selmanturunc/POSITION-CONTROL-OF-THE-BALL-ROLLING-ON-A-FLAT-PLATFORM/Design Drawings/servo_project 2.png

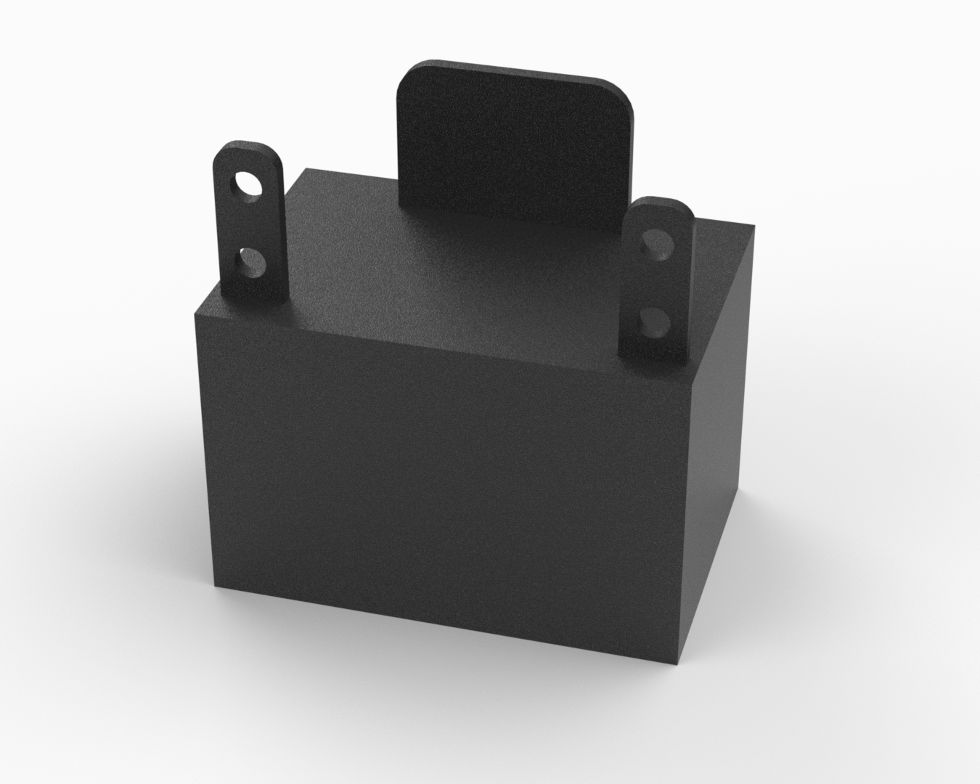
Design Drawings/servo_project 2.png
