selmanturunc/POSITION-CONTROL-OF-THE-BALL-ROLLING-ON-A-FLAT-PLATFORM/README.md

# 2 DoF Ball and Plate Project (PID and Fuzzy Logic Controller) 
### MARMARA UNIVERSITY,TURKEY
#### ME4098 - Engineering Project 
*Selman TURUNÇ*  <br/>
[LinkedIn](https://www.linkedin.com/in/selmanturunc/)
