selmanturunc/POSITION-CONTROL-OF-THE-BALL-ROLLING-ON-A-FLAT-PLATFORM/Design Drawings/BasePlane.png

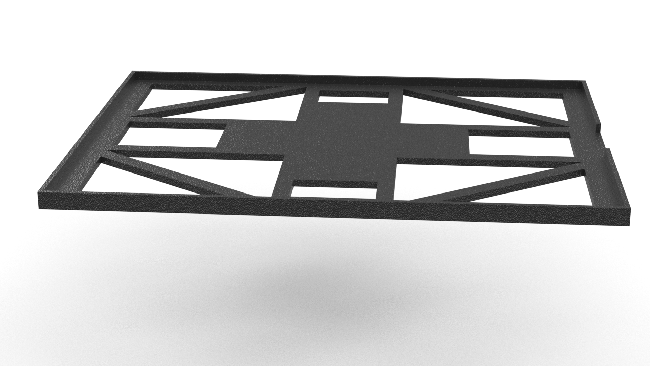
Design Drawings/BasePlane.png
