selmanturunc/POSITION-CONTROL-OF-THE-BALL-ROLLING-ON-A-FLAT-PLATFORM/Photos real system/IMG_20210701_142903.jpg

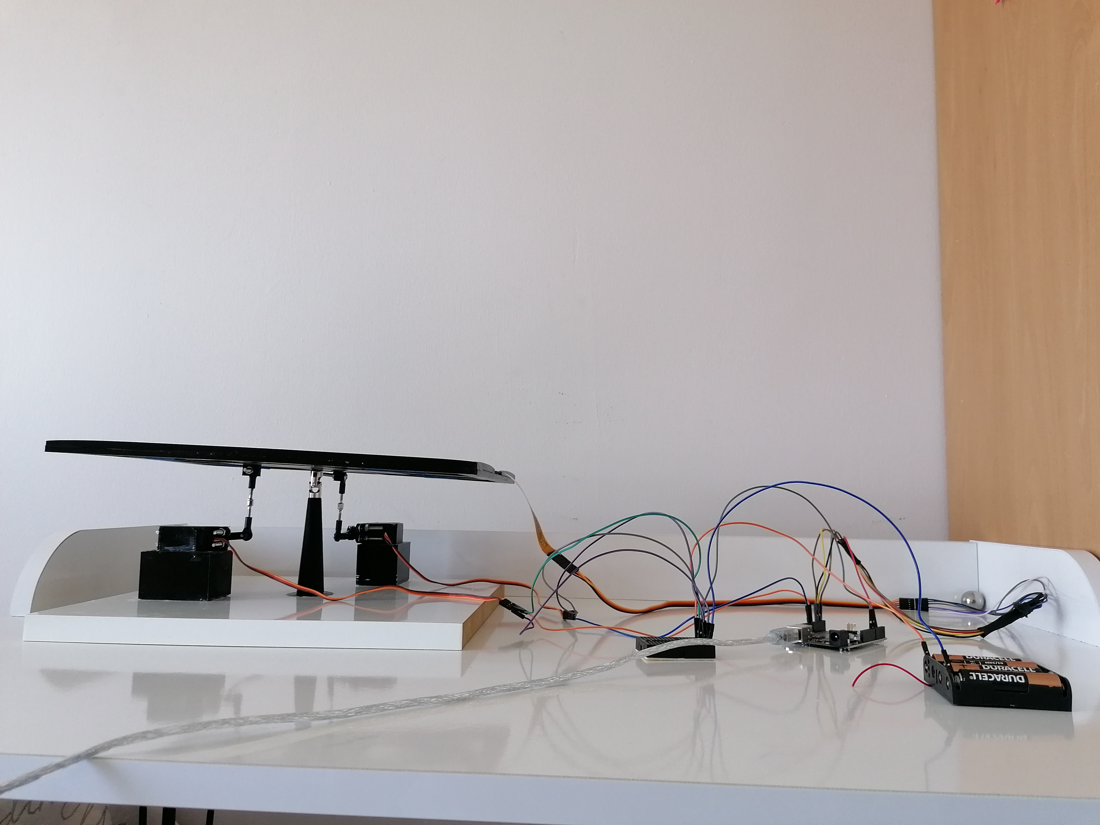
Photos real system/IMG_20210701_142903.jpg
