selmanturunc/POSITION-CONTROL-OF-THE-BALL-ROLLING-ON-A-FLAT-PLATFORM/Photos real system/IMG_20210701_143029.jpg

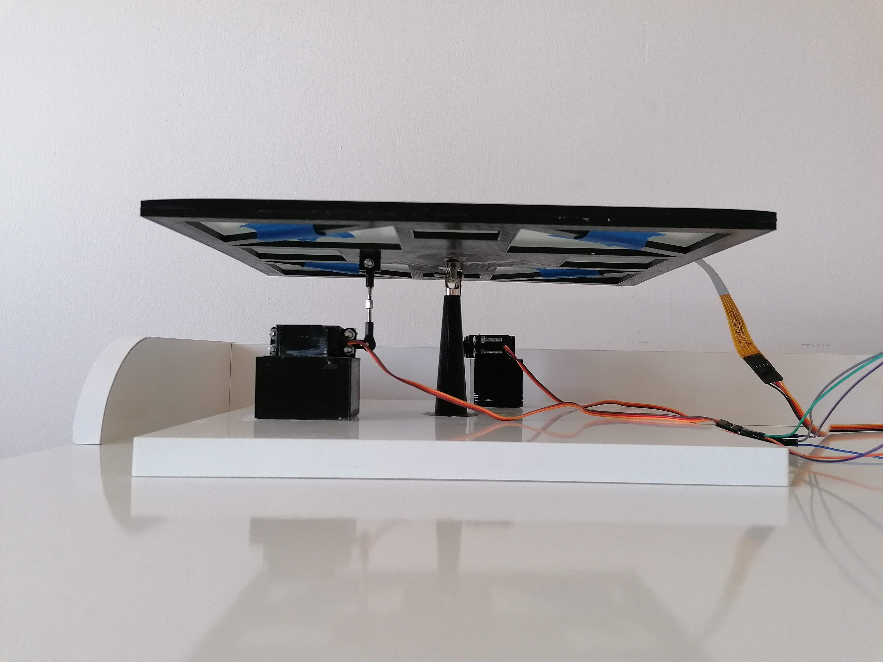
Photos real system/IMG_20210701_143029.jpg
