selmanturunc/POSITION-CONTROL-OF-THE-BALL-ROLLING-ON-A-FLAT-PLATFORM/Design Drawings/mg996r/MG996R.SLDASM

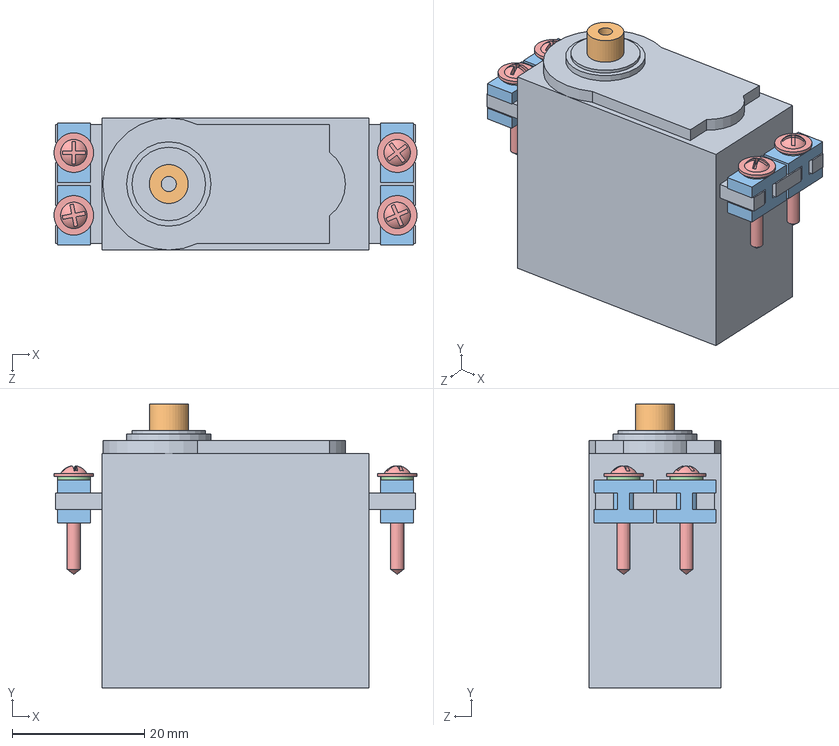
[picture p50: CAD file, 2021-09-07]
Design Drawings/mg996r/MG996R.SLDASM
55.0 x 43.0 x 20.0 mm
servo
shaft
Rubber x 4
bushing x 4
screw x 4
