selmanturunc/POSITION-CONTROL-OF-THE-BALL-ROLLING-ON-A-FLAT-PLATFORM/Design Drawings/BasePlakaAsm.SLDASM

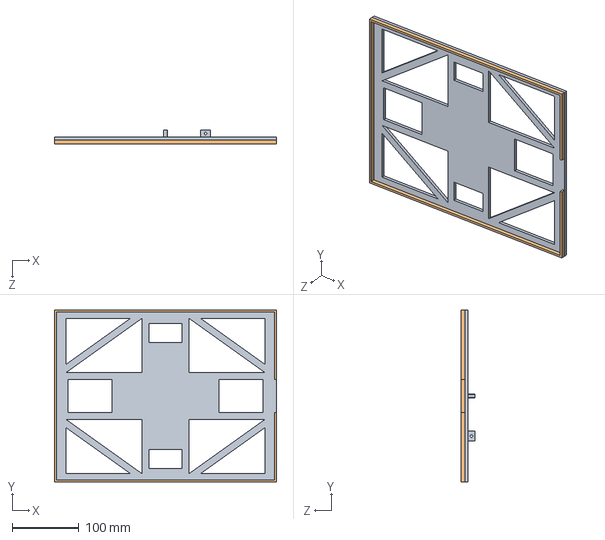
[picture p51: CAD file, 2021-09-07]
Design Drawings/BasePlakaAsm.SLDASM
332.2 x 257.2 x 20.5 mm
Table1_ALT
table_Ust
