selmanturunc/POSITION-CONTROL-OF-THE-BALL-ROLLING-ON-A-FLAT-PLATFORM/Design Drawings/Direk.SLDPRT

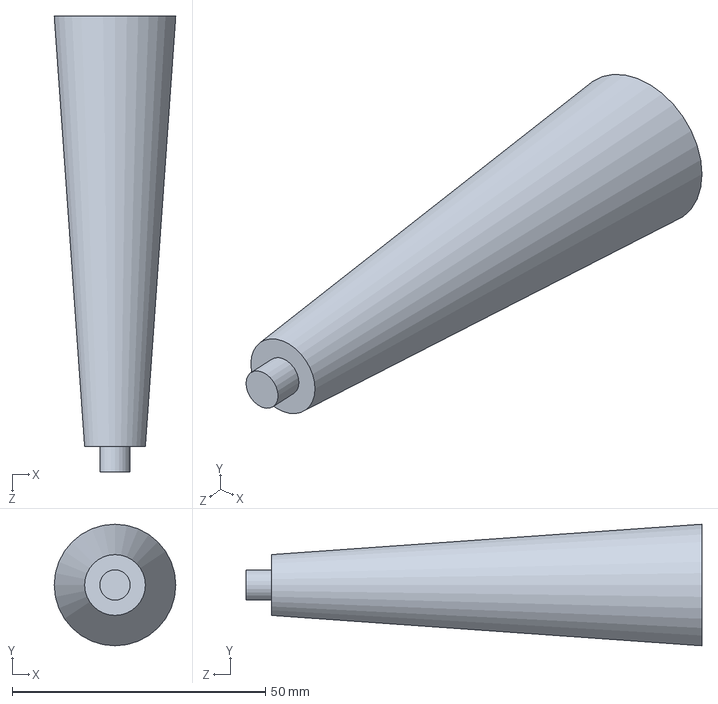
[picture p52: CAD file, 2021-09-07]
Design Drawings/Direk.SLDPRT
24.0 x 24.0 x 90.0 mm
