selmanturunc/POSITION-CONTROL-OF-THE-BALL-ROLLING-ON-A-FLAT-PLATFORM/Design Drawings/Table1_ALT.SLDPRT

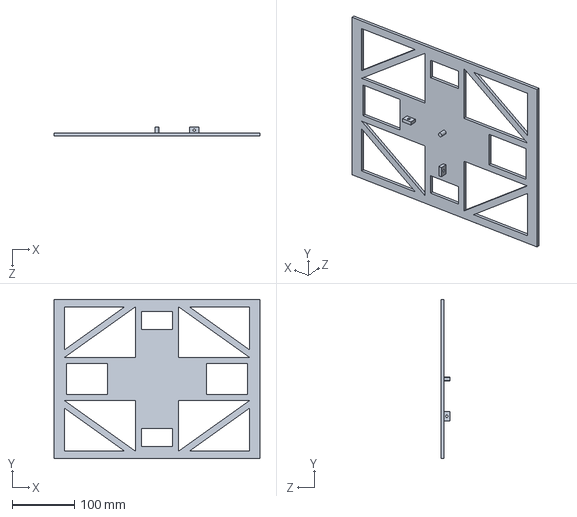
[picture p53: CAD file, 2021-09-07]
Design Drawings/Table1_ALT.SLDPRT
332.2 x 257.2 x 14.5 mm
