selmanturunc/POSITION-CONTROL-OF-THE-BALL-ROLLING-ON-A-FLAT-PLATFORM/Design Drawings/ball.SLDPRT

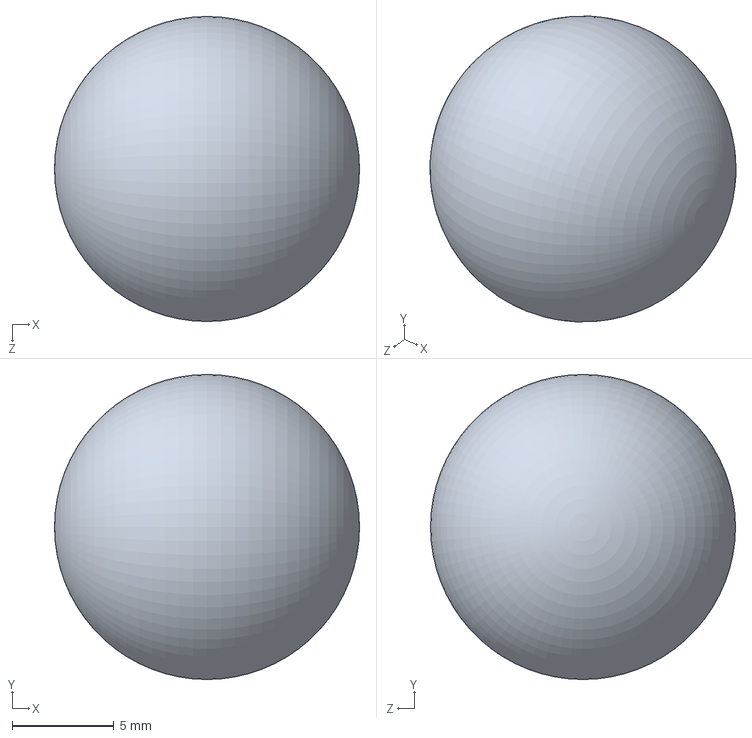
[picture p54: CAD file, 2021-09-07]
Design Drawings/ball.SLDPRT
15.0 x 15.0 x 15.0 mm
