selmanturunc/POSITION-CONTROL-OF-THE-BALL-ROLLING-ON-A-FLAT-PLATFORM/Design Drawings/mg996r/Rubber.SLDPRT

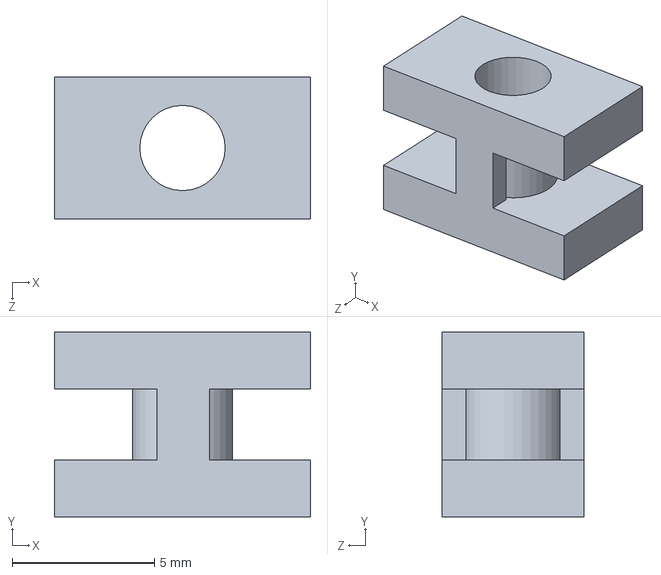
[picture p55: CAD file, 2021-09-07]
Design Drawings/mg996r/Rubber.SLDPRT
9.00 x 6.50 x 5.00 mm
