selmanturunc/POSITION-CONTROL-OF-THE-BALL-ROLLING-ON-A-FLAT-PLATFORM/Design Drawings/mg996r/shaft.SLDPRT

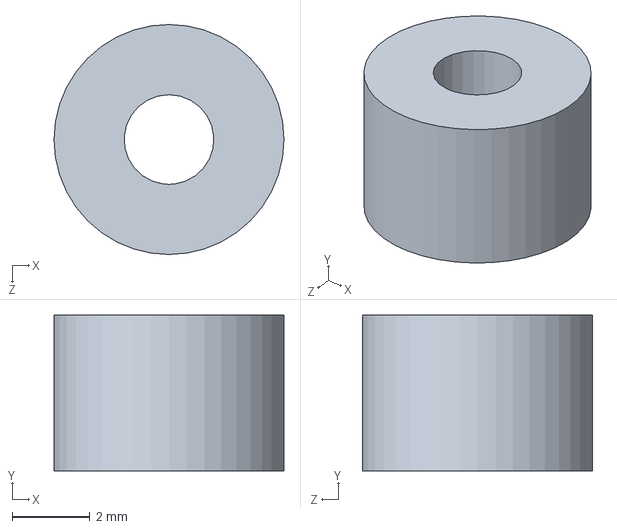
[picture p56: CAD file, 2021-09-07]
Design Drawings/mg996r/shaft.SLDPRT
5.90 x 4.00 x 5.90 mm
