selmanturunc/POSITION-CONTROL-OF-THE-BALL-ROLLING-ON-A-FLAT-PLATFORM/Design Drawings/mg996r/servo.SLDPRT

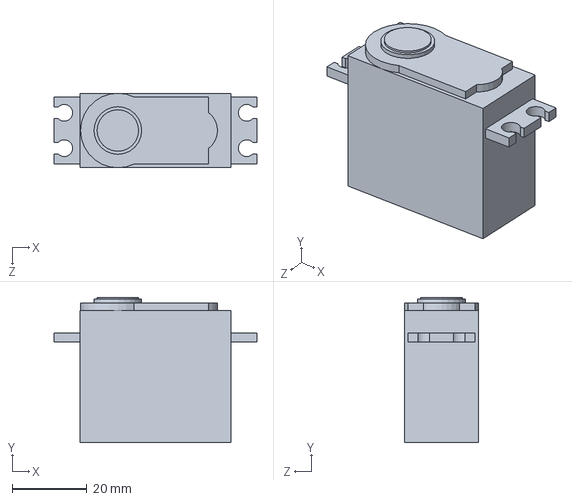
[picture p57: CAD file, 2021-09-07]
Design Drawings/mg996r/servo.SLDPRT
54.5 x 39.0 x 20.0 mm
