selmanturunc/POSITION-CONTROL-OF-THE-BALL-ROLLING-ON-A-FLAT-PLATFORM/Design Drawings/table_Ust.SLDPRT

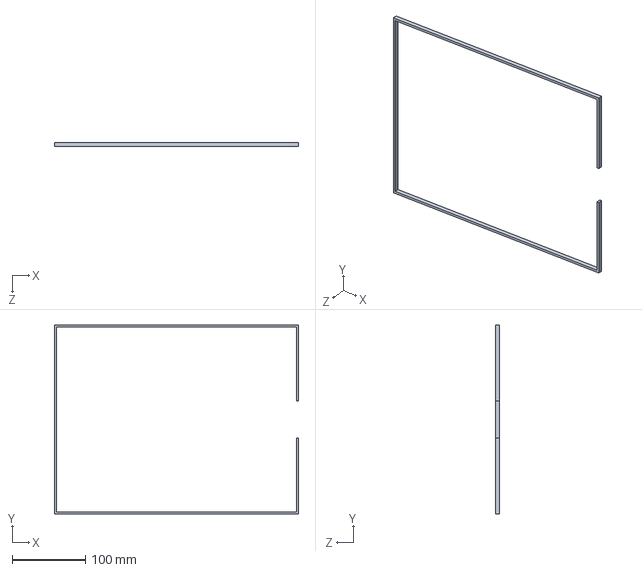
[picture p58: CAD file, 2021-09-07]
Design Drawings/table_Ust.SLDPRT
332.2 x 257.2 x 6.00 mm
