selmanturunc/POSITION-CONTROL-OF-THE-BALL-ROLLING-ON-A-FLAT-PLATFORM/Design Drawings/mg996r/bushing.SLDPRT

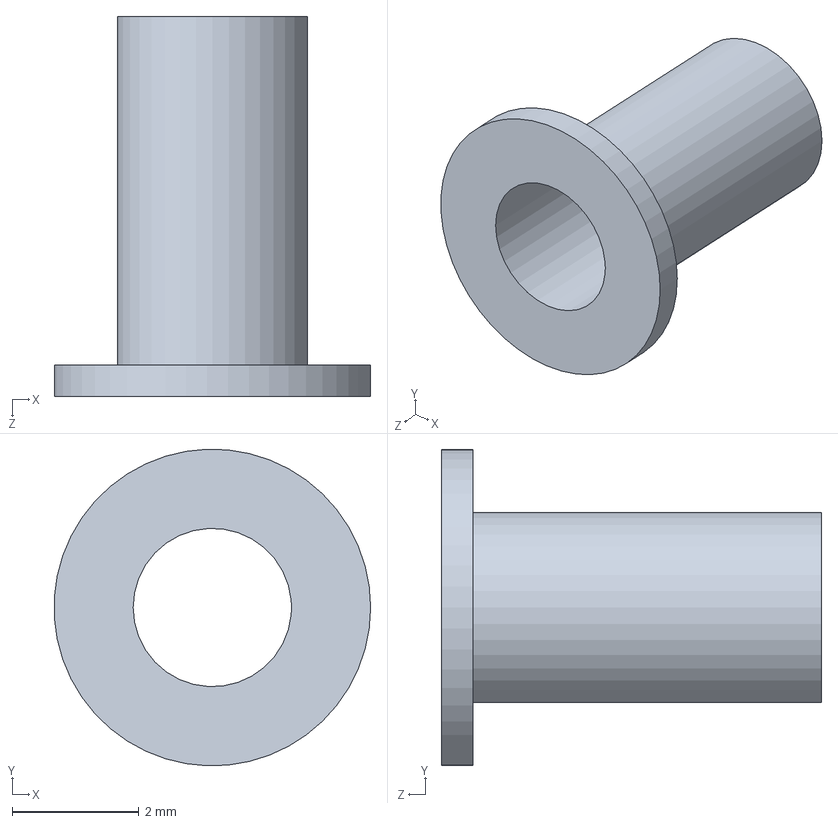
[picture p59: CAD file, 2021-09-07]
Design Drawings/mg996r/bushing.SLDPRT
4.99 x 5.00 x 6.00 mm
