selmanturunc/POSITION-CONTROL-OF-THE-BALL-ROLLING-ON-A-FLAT-PLATFORM/Design Drawings/Servo arm kst x10.SLDPRT

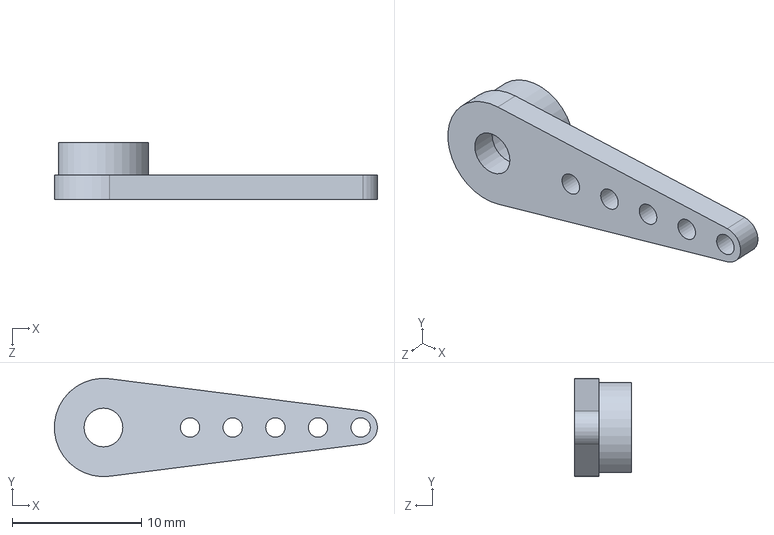
[picture p60: CAD file, 2021-09-07]
Design Drawings/Servo arm kst x10.SLDPRT
25.0 x 7.59 x 4.40 mm
