selmanturunc/POSITION-CONTROL-OF-THE-BALL-ROLLING-ON-A-FLAT-PLATFORM/Design Drawings/Arm2.SLDPRT

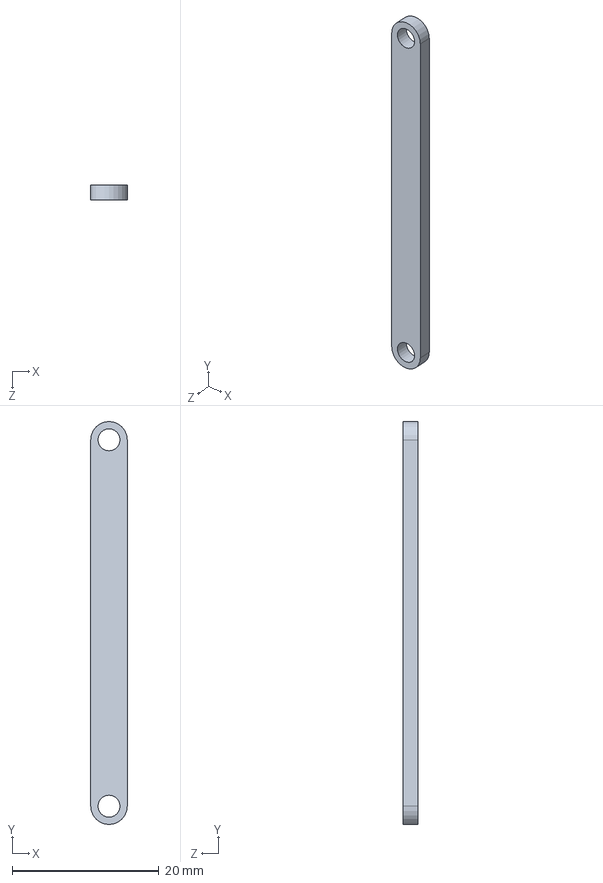
[picture p61: CAD file, 2021-09-07]
Design Drawings/Arm2.SLDPRT
5.00 x 55.0 x 2.00 mm
