selmanturunc/POSITION-CONTROL-OF-THE-BALL-ROLLING-ON-A-FLAT-PLATFORM/Design Drawings/uJoint.SLDPRT

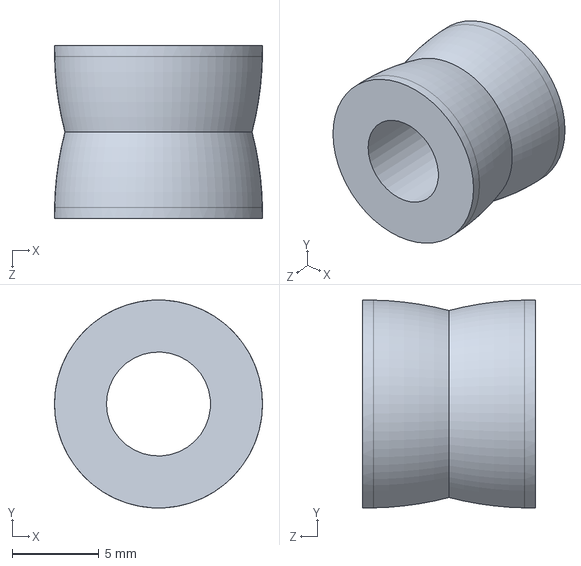
[picture p62: CAD file, 2021-09-07]
Design Drawings/uJoint.SLDPRT
12.0 x 12.0 x 10.0 mm
