selmanturunc/POSITION-CONTROL-OF-THE-BALL-ROLLING-ON-A-FLAT-PLATFORM/Design Drawings/servo_holder.SLDPRT

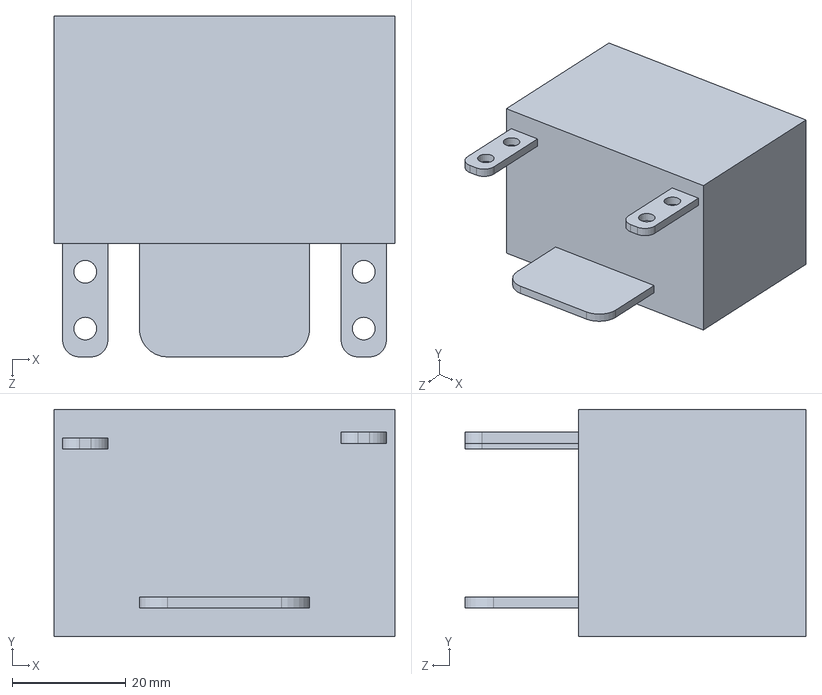
[picture p63: CAD file, 2021-09-07]
Design Drawings/servo_holder.SLDPRT
60.0 x 40.0 x 60.0 mm
