selmanturunc/POSITION-CONTROL-OF-THE-BALL-ROLLING-ON-A-FLAT-PLATFORM/Design Drawings/base_wood.SLDPRT

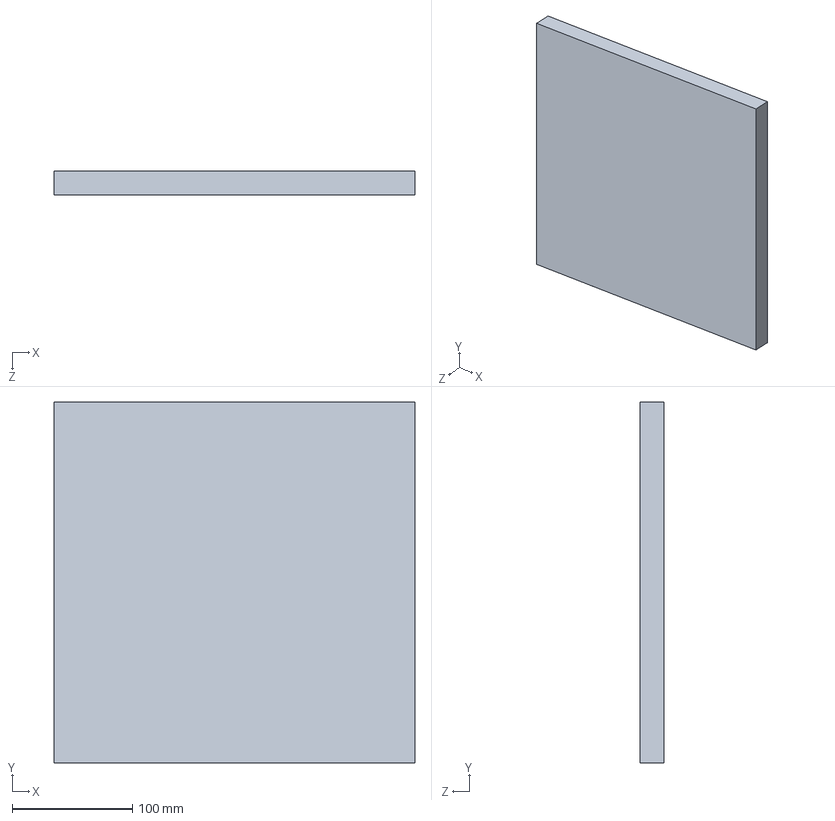
[picture p64: CAD file, 2021-09-07]
Design Drawings/base_wood.SLDPRT
300.0 x 300.0 x 20.0 mm
