selmanturunc/POSITION-CONTROL-OF-THE-BALL-ROLLING-ON-A-FLAT-PLATFORM/Design Drawings/TouchScreen.SLDPRT

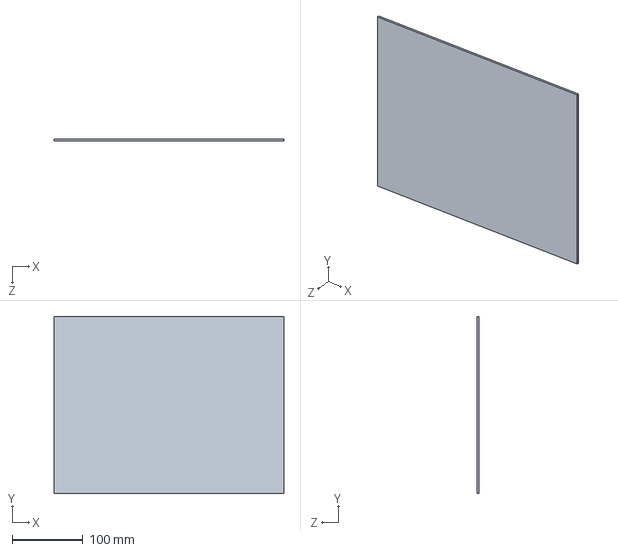
[picture p65: CAD file, 2021-09-07]
Design Drawings/TouchScreen.SLDPRT
326.2 x 251.2 x 3.00 mm
