selmanturunc/POSITION-CONTROL-OF-THE-BALL-ROLLING-ON-A-FLAT-PLATFORM/Design Drawings/mg996r/screw.SLDPRT

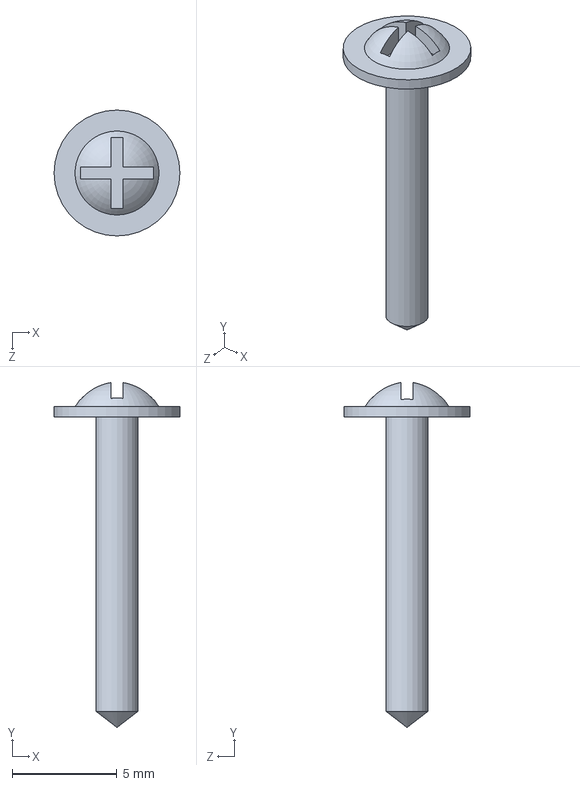
[picture p66: CAD file, 2021-09-07]
Design Drawings/mg996r/screw.SLDPRT
6.00 x 16.4 x 6.00 mm
