selmanturunc/POSITION-CONTROL-OF-THE-BALL-ROLLING-ON-A-FLAT-PLATFORM/(list of files, cad)

Other CAD files:
Design Drawings/BallAndPlateAsm.SLDDRW
