selmanturunc/POSITION-CONTROL-OF-THE-BALL-ROLLING-ON-A-FLAT-PLATFORM/Experiment Data/Fuzzy/Fuzzy.xlsx

Sheet: Fuzzy System Response
t | x | xdat | outx | y | ydat | outy
0 | 10.6 | 0.16 | 11.68 | 1 | 0 | 2.02
0.034 | 10.8 | 0 | 14.6 | 0.9 | 0 | 1.86
0.136 | 10.9 | 0 | 14.69 | 0.9 | 0 | 1.86
0.187 | 10.8 | -1.5 | 4.6 | 1 | 0 | 2.02
0.269 | 10.4 | -0.16 | 12.88 | 1.1 | -0.16 | 0.59
0.357 | 9.6 | -0.33 | 11.04 | 0.9 | 0 | 1.86
0.4 | 8.8 | -0.16 | 12.09 | 0.8 | 1.5 | 11.7
0.472 | 7.9 | -0.65 | 6.64 | 0.7 | -0.16 | -0.15
0.569 | 6.5 | -0.65 | 3.59 | 0.6 | 0 | 1.34
0.637 | 5 | -0.65 | 1.55 | 0.2 | -0.16 | -1.25
0.719 | 3.4 | -0.98 | -1.59 | -0.2 | -0.16 | -2.34
0.768 | 1.4 | -0.81 | -4 | -0.5 | -0.16 | -3.11
0.883 | -0.4 | -0.98 | -3.11 | -0.8 | 0 | -1.78
0.918 | -2.4 | -0.98 | -9.18 | -1 | 0 | -2.01
1.02 | -4.3 | -0.33 | -7.43 | -1.1 | 0 | -2.12
1.068 | -5.9 | -0.98 | -13.94 | -1 | -0.16 | -4
1.152 | -7.7 | -0.81 | -15.36 | -1 | 0 | -2.01
1.221 | -9.4 | -0.49 | -13.99 | -0.8 | 0 | -1.78
1.303 | -10.6 | -0.49 | -14.9 | -0.5 | -1.5 | -11.43
1.351 | -11.7 | -0.16 | -15.51 | -0.2 | -1.5 | -11.08
1.435 | -12.4 | -0.33 | -16.31 | 0 | 0.33 | 2.89
1.519 | -13 | 0 | -16.68 | 0.5 | 0.49 | 2.52
1.619 | -13.2 | 0.16 | -16.43 | 1.5 | 0.65 | 6.14
1.652 | -13 | 0 | -16.68 | 2.6 | -1.5 | -6.06
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
