selmanturunc/POSITION-CONTROL-OF-THE-BALL-ROLLING-ON-A-FLAT-PLATFORM/Experiment Data/PID/PID Real Time Response.xlsx

Sheet: system response1
t | x | y
0 | 14.9 | 0.4 | 0 | 14.9 |  |  | t | x | y
0.033 | 14.9 | 0.4 | 0.033 | 14.9 |  |  | 0 | 14.9 | 0.4
0.084 | 14.8 | 0.4 | 0.084 | 14.8 |  |  | 0.033 | 14.9 | 0.4
0.134 | 14.9 | 0.5 | 0.134 | 14.9 |  |  | 0.084 | 14.8 | 0.4
0.183 | 14.9 | 0.6 | 0.183 | 14.9 |  |  | 0.134 | 14.9 | 0.5
0.216 | 0.2 | 0.7 | 0.216 | 14.6 |  |  | 0.183 | 14.9 | 0.6
0.25 | 14.4 | 0.5 | 0.25 | 14.4 |  |  | 0.216 | 0.2 | 0.7
0.3 | 13.8 | 0.3 | 0.3 | 13.8 |  |  | 0.25 | 14.4 | 0.5
0.35 | 13.1 | 0.2 | 0.35 | 13.1 |  |  | 0.3 | 13.8 | 0.3
0.4 | -0.4 | 0.1 | 0.4 | 12 |  |  | 0.35 | 13.1 | 0.2
0.449 | 10.8 | 0.1 | 0.449 | 10.8 |  |  | 0.4 | -0.4 | 0.1
0.449 | 9.4 | 0.1 | 0.449 | 9.4 |  |  | 0.449 | 10.8 | 0.1
0.526 | 8.1 | 0 | 0.526 | 8.1 |  |  | 0.449 | 9.4 | 0.1
0.567 | 6.7 | 0.1 | 0.567 | 6.7 |  |  | 0.526 | 8.1 | 0
0.608 | 5.2 | 0.3 | 0.608 | 5.2 |  |  | 0.567 | 6.7 | 0.1
0.643 | 3.6 | 0.4 | 0.643 | 3.6 |  |  | 0.608 | 5.2 | 0.3
0.677 | 2.2 | 0.6 | 0.677 | 2.2 | rise time | 0.4023 | 0.643 | 3.6 | 0.4
0.717 | 1.1 | 0.9 | 0.717 | 1.1 |  |  | 0.677 | 2.2 | 0.6
0.759 | -0.1 | 1.2 | 0.759 | -0.1 |  |  | 0.717 | 1.1 | 0.9
0.8 | -1 | 1.6 | 0.8 | -1 |  |  | 0.759 | -0.1 | 1.2
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
